skainen/docking-station/docs/IoT2_Hardware_store_list.odt

IoT Project 2 — hardware / hobby store

Mechanical parts for the contact mechanism. Buy locally (hobby, robotics or hardware store).

Robot side

Part | Specification | Qty | Purpose
Brass rod | Ø4 mm, ~300 mm | 1 | Contact rods, 2 × ~60 mm with rounded tips
Small torsion or extension springs | Torsion: ~0.4–0.5 mm wire, Ø5–6 mm, fits M3 axle, ≥150° travel. Or extension: ~Ø4–5 mm, 15–20 mm long, light | 4–6 | Return springs (2 per rod carrier): rods retract if servo unpowered. A small spring assortment box covers this

Dock side

Part | Specification | Qty | Purpose
Brass or copper strip | 0.5–1 mm thick, ~25 mm wide, ~300 mm | 1 | Contact rails, 2 × 70–90 mm
Compression spring assortment | Ø4–6 mm, soft | 1 set | Rail springs, 6–8 mm travel

Shared

Part | Specification | Qty | Purpose
M3 screws + heat-set inserts | Assorted lengths 8–20 mm | 1 set | Rail guide pins, hinge, part joints (skip if in lab)
PETG filament | Black, 1.75 mm | 1 kg | Station, pad and robot brackets; black for IR parts (skip if in lab)
