skainen/docking-station/hardware/images/dock_preview.png

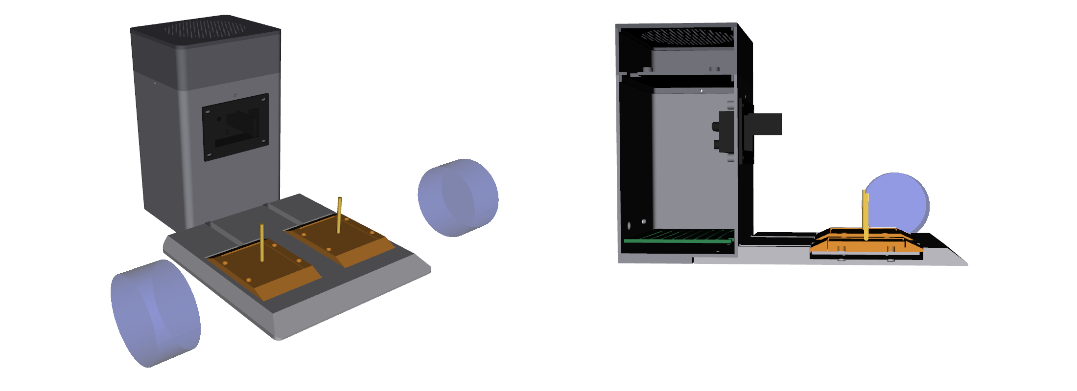
hardware/images/dock_preview.png
