skainen/docking-station/hardware/images/docking.png

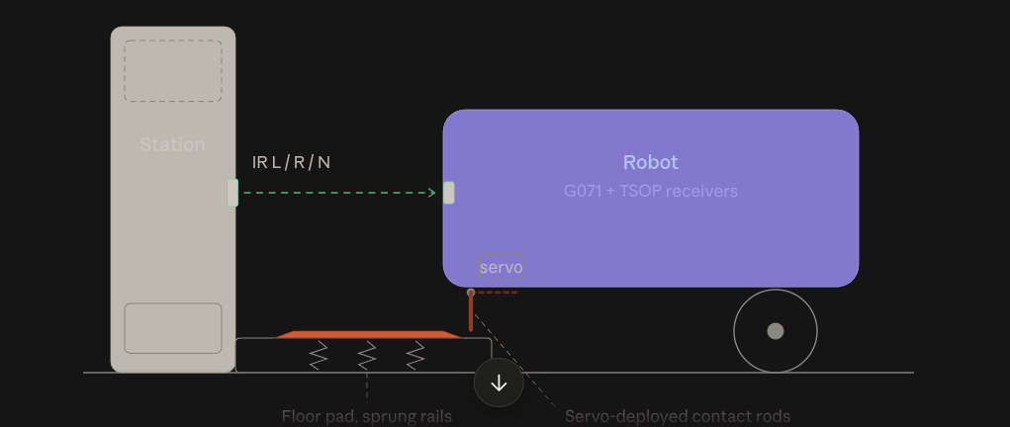
hardware/images/docking.png
