skainen/docking-station/docs/IoT_Project_2_Group_1_Parts.odt

IoT Project 2, Group 1 — DigiKey order

Main electronic components for the IR docking system and contact mechanism.

Docking station

Part | Specification | Qty | Purpose | Link
STMicroelectronics NUCLEO-G031K8 | Dev board, STM32G031K8 | 1 | Dock MCU: 38 kHz carrier + per-zone IR codes | https://www.digikey.fi/fi/products/detail/stmicroelectronics/NUCLEO-G031K8/10321671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
Vishay TSAL6200 | IR emitter, 940 nm, 5 mm, ±17° | 12 | Beacon LEDs: 2 L, 2 R, 1–2 near-field + spares | https://www.digikey.fi/en/products/detail/stmicroelectronics/NUCLEO-G071RB/9739925https://www.digikey.fi/en/products/detail/vishay-semiconductor-opto-division/TSAL62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
Infineon IRLZ44NPBF | Logic-level N-MOSFET, 55 V, TO-220 | 3 | LED channel switches (left, right, near) | https://www.digikey.fi/en/products/detail/vishay-semiconductor-opto-division/TSOP38238/1681362https://www.digikey.fi/fi/products/detail/infineon-technologies/IRLZ44N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

Robot

Part | Specification | Qty | Purpose | Link
STMicroelectronics NUCLEO-G071RB | Dev board, STM32G071RB | 1 | Docking controller | https://www.digikey.fi/en/products/detail/stmicroelectronics/NUCLEO-G071RB/9739925
Vishay TSOP38238 | IR receiver module, 38 kHz | 6 | 3 receivers + spares | https://www.digikey.fi/en/products/detail/vishay-semiconductor-opto-division/TSOP38238/1681362
Omron D2F-01L | Subminiature switch, hinge lever, gold contacts | 2 | Rod deploy confirmation (1 + spare); gold contacts for logic-level signal | https://www.digikey.fi/fi/products/detail/omron-electronics-inc-emc-div/D2F-L/83251
Adafruit 1450 servo motor | Servo for robot side connector rods | 2 | Deploys contact rods (1 + spare) | https://www.digikey.fi/fi/products/detail/adafruit-industries-llc/1450/5154665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

From lab stock

We can pick up these ourselves:

Resistors (1/4 W): 56 Ω ×4, 220 Ω ×2, 150 Ω ×3, 100 kΩ ×3, 100 Ω ×3. Capacitors: 100 µF ≥10 V electrolytic ×1, 100 nF ceramic ×8, jumper wires.

We also need to pick up some brass rod, springs and screws from store, which are not available from DigiKey, but are very cheap so not a problem.
