skainen/docking-station/hardware/3d/docking_station_assembly.step

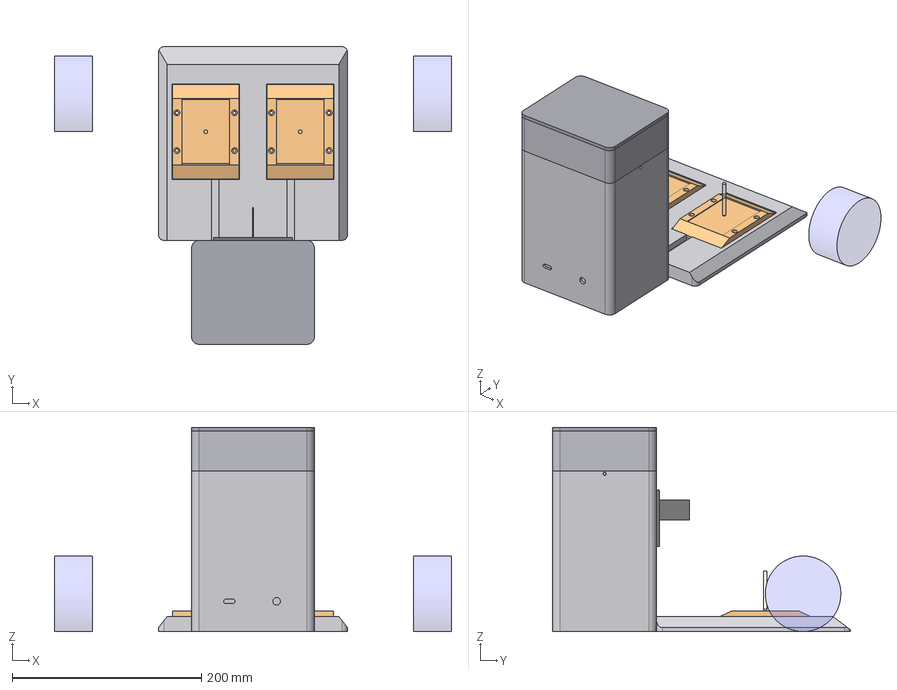
[picture p4: CAD file, 2026-10-26]
hardware/3d/docking_station_assembly.step
420.0 x 315.0 x 216.0 mm
tower_shell
top_bay
top_cap_blank
ir_module
electronics_tray
contact_pad
rail_carrier_L
rail_carrier_R
REF_robot_rods
REF_robot_wheels
