skainen/docking-station/hardware/3d/ir_module.stl

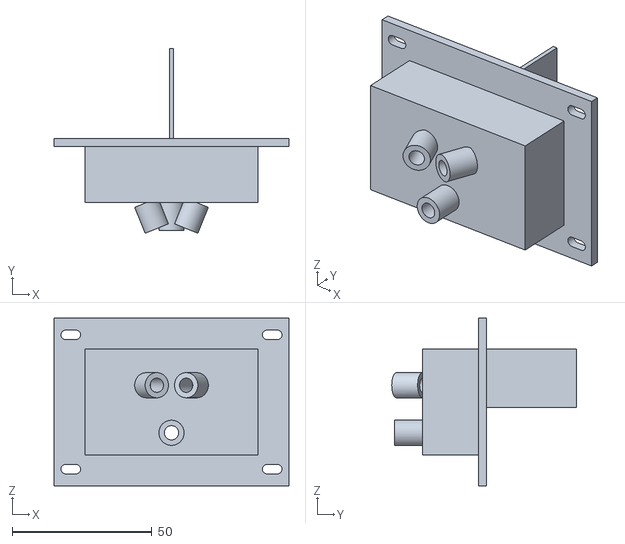
[picture p5: CAD file, 2026-10-26]
hardware/3d/ir_module.stl
84.0 x 66.0 x 60.0
