skainen/docking-station/hardware/3d/top_cap_grille.stl

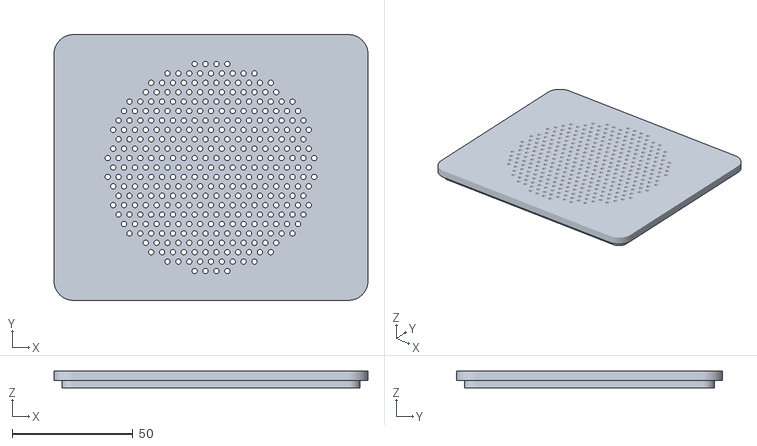
[picture p6: CAD file, 2026-10-26]
hardware/3d/top_cap_grille.stl
130.0 x 110.0 x 7.00
