skainen/docking-station/hardware/3d/contact_pad.stl

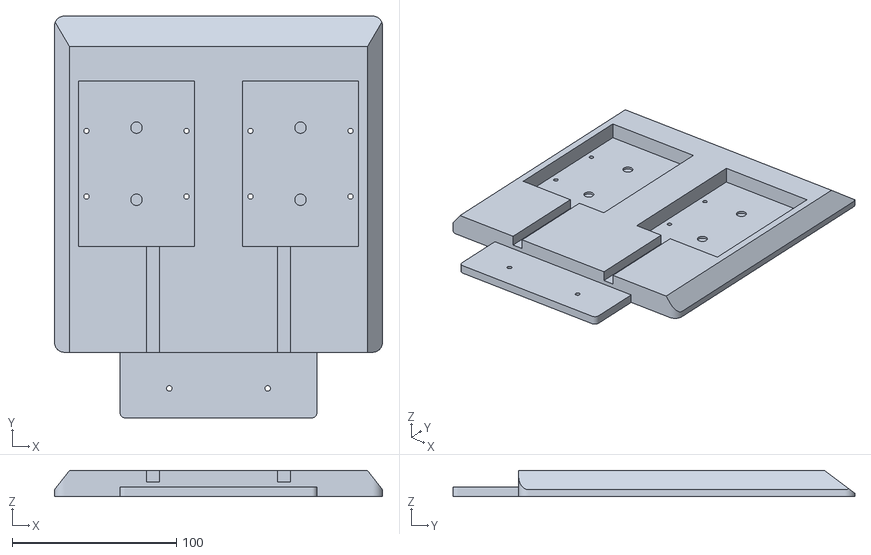
[picture p7: CAD file, 2026-10-26]
hardware/3d/contact_pad.stl
200.0 x 245.0 x 16.0
