skainen/docking-station/hardware/3d/top_bay.stl

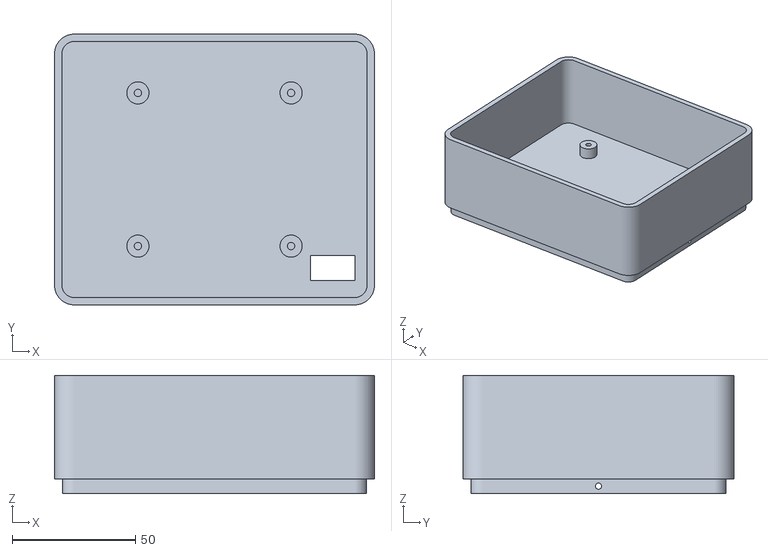
[picture p8: CAD file, 2026-10-26]
hardware/3d/top_bay.stl
130.0 x 110.0 x 48.0
