skainen/docking-station/hardware/3d/tower_shell.stl

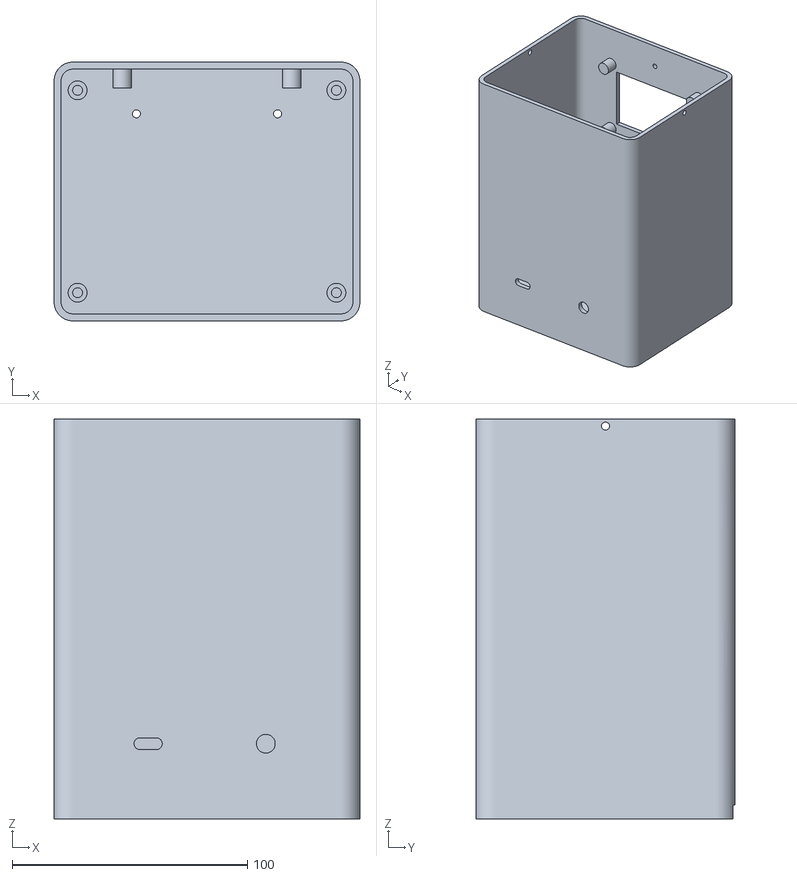
[picture p9: CAD file, 2026-10-26]
hardware/3d/tower_shell.stl
130.0 x 110.0 x 170.0
