skainen/docking-station/hardware/3d/electronics_tray.stl

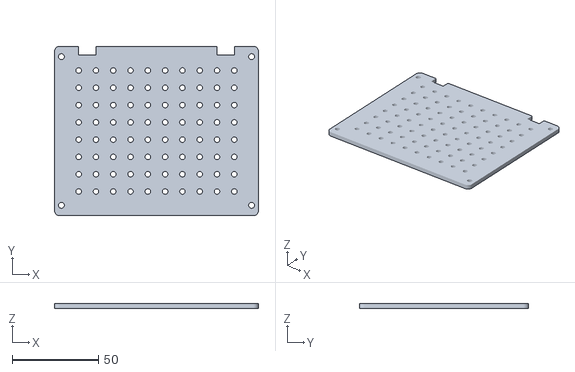
[picture p10: CAD file, 2026-10-26]
hardware/3d/electronics_tray.stl
118.0 x 98.0 x 3.00
