skainen/docking-station/hardware/3d/top_cap_blank.stl

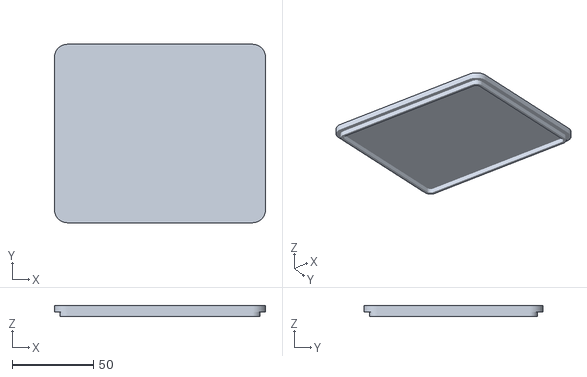
[picture p11: CAD file, 2026-10-26]
hardware/3d/top_cap_blank.stl
130.0 x 110.0 x 7.00
