skainen/docking-station/hardware/3d/rail_carrier_x2.stl

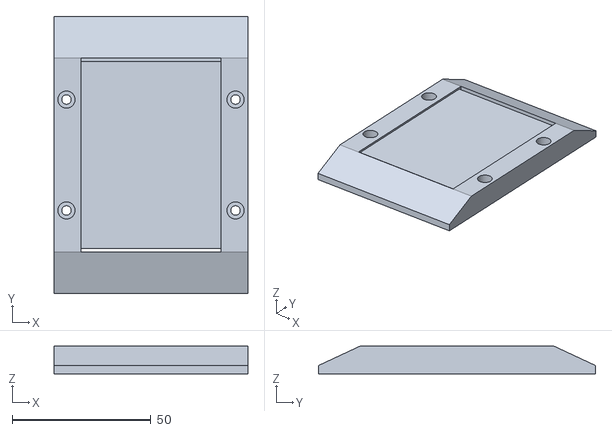
[picture p12: CAD file, 2026-10-26]
hardware/3d/rail_carrier_x2.stl
70.0 x 100.0 x 10.0
